Mlkurta/ENCE_3231_Embedded_Systems/PhaseB/STM32Demo/Readme.md

# STM32 Demo

This is a Project created by mirroring the KiCAD board design process by Philip Salmony of Phil's Lab.

The creation video can be found here: https://youtu.be/aVUqaB0IMh4?si=m5vGeWEMC6P6GTJ3

Schematic:



Board layout:

PCB_Layout

Board Model:
