Mlkurta/ENCE_3231_Embedded_Systems/Phase_A/Ultrasonic_Project/Readme.md

STM_Ultrasoun

(Range variable is at the bottom in cm)
