Mlkurta/ENCE_3231_Embedded_Systems/PhaseB/2_Wheel_Robot_Complete/Docs/Board_Back.png

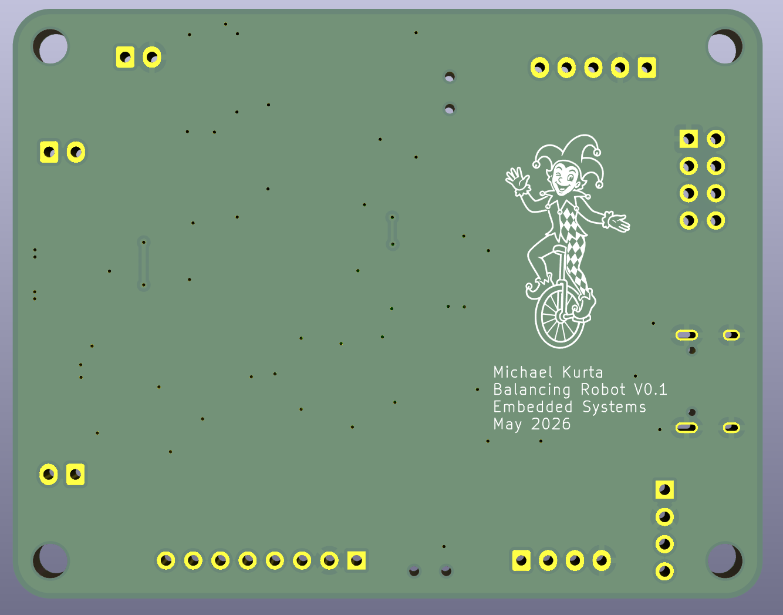
PhaseB/2_Wheel_Robot_Complete/Docs/Board_Back.png
