Mlkurta/ENCE_3231_Embedded_Systems/PhaseB/2_Wheel_Robot_Complete/Docs/Layout.png

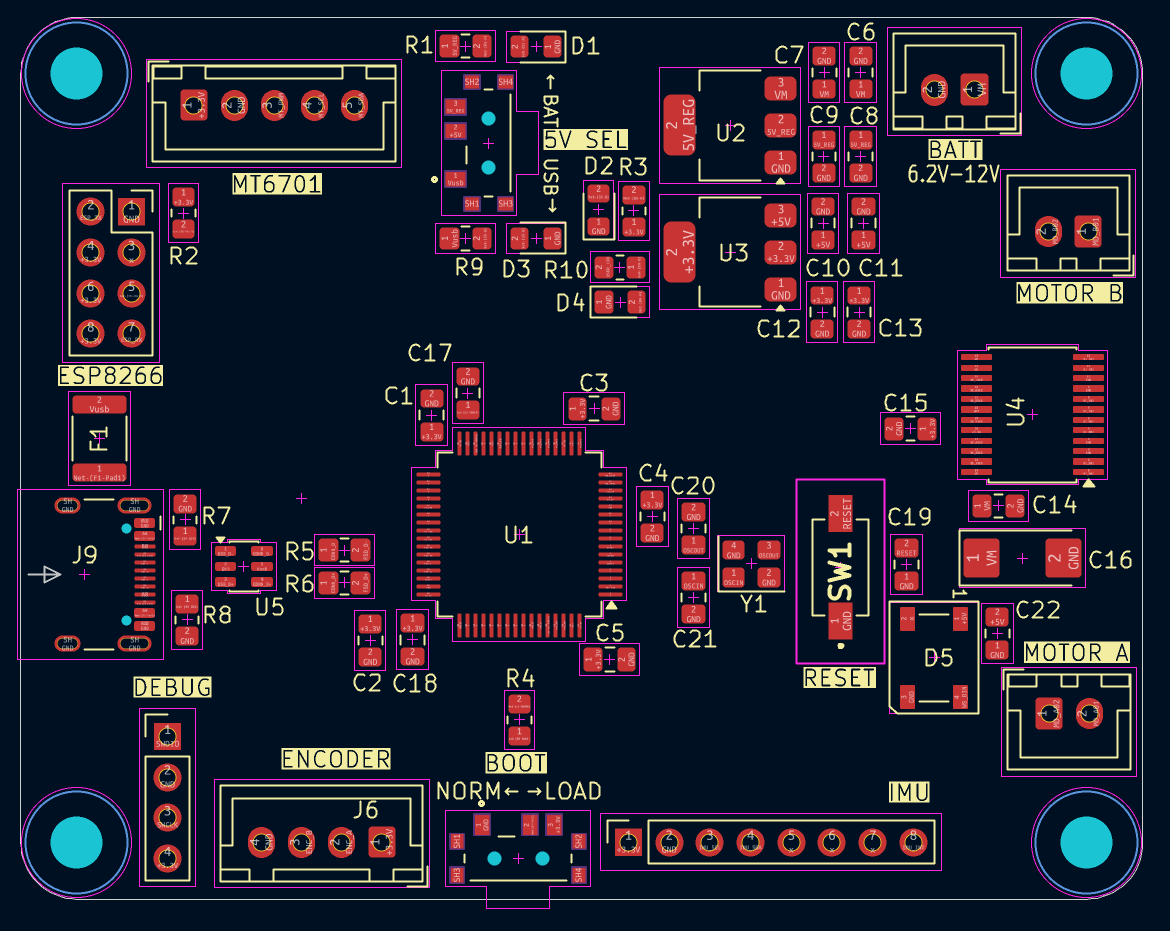
PhaseB/2_Wheel_Robot_Complete/Docs/Layout.png
