Mlkurta/ENCE_3231_Embedded_Systems/PhaseB/STM32Demo/Docs/Board_Front.png

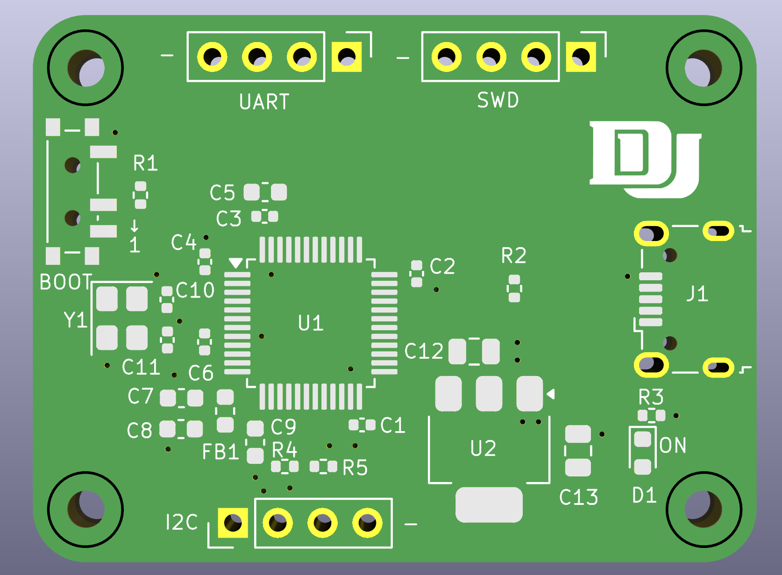
PhaseB/STM32Demo/Docs/Board_Front.png
