Mlkurta/ENCE_3231_Embedded_Systems/PhaseB/STM32Demo/Docs/PCB_Layout.png

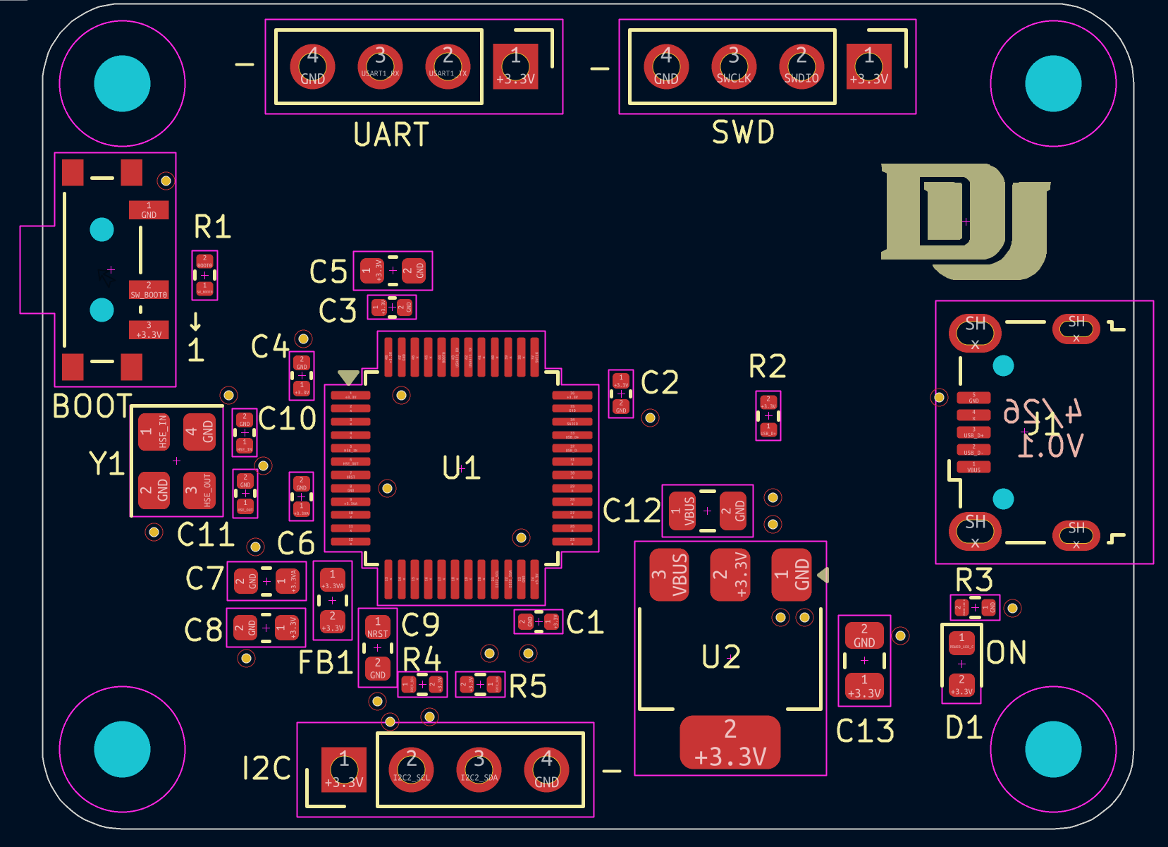
PhaseB/STM32Demo/Docs/PCB_Layout.png
