Mlkurta/ENCE_3231_Embedded_Systems/PhaseB/2_Wheel_Robot_Complete/Components/components/ESP8266-01_ESP-01/step/ESP8266-01_ESP-01.step

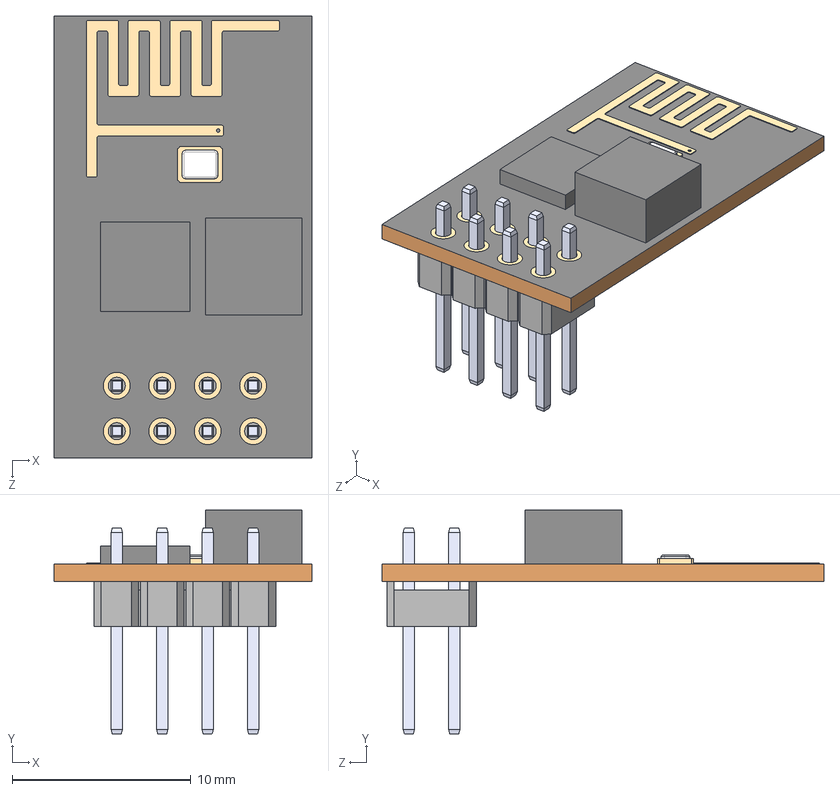
[picture p10: CAD file, 2026-04-23]
PhaseB/2_Wheel_Robot_Complete/Components/components/ESP8266-01_ESP-01/step/ESP8266-01_ESP-01.step
14.4 x 12.5 x 24.7 mm
