Mlkurta/ENCE_3231_Embedded_Systems/PhaseB/2_Wheel_Robot_Complete/Components/components/MPU6050/ITG-MPU.STEP

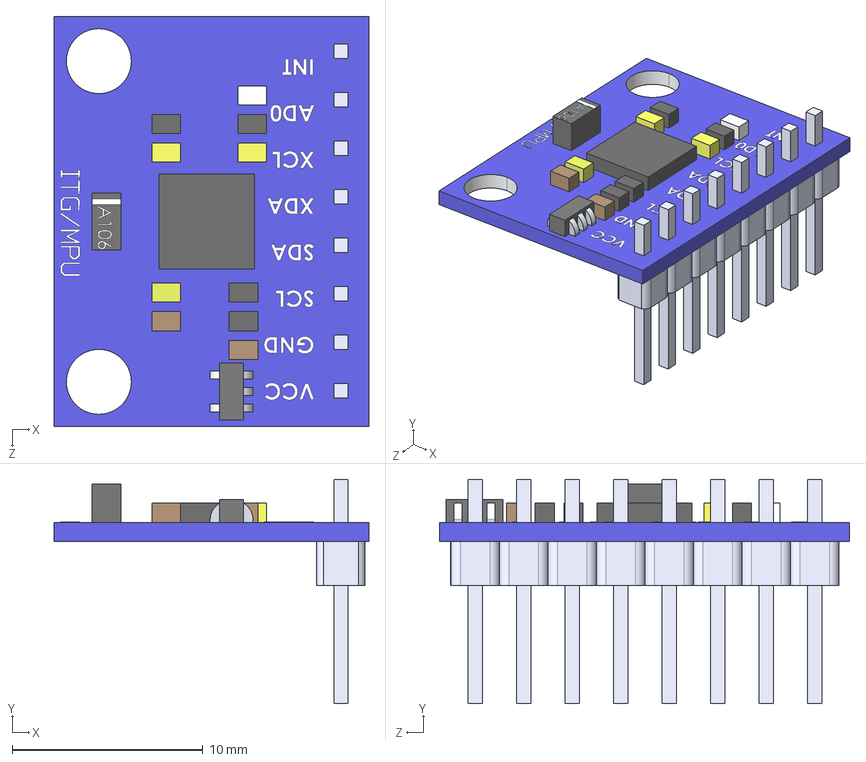
[picture p12: CAD file, 2026-04-23]
PhaseB/2_Wheel_Robot_Complete/Components/components/MPU6050/ITG-MPU.STEP
16.5 x 11.8 x 21.5 mm
8 Header-Pin
Placa_Base
