Mlkurta/ENCE_3231_Embedded_Systems/PhaseB/2_Wheel_Robot_Complete/Components/components/SPDT_Slide_Switch/step/SLW-66527511-SMT-TR.step

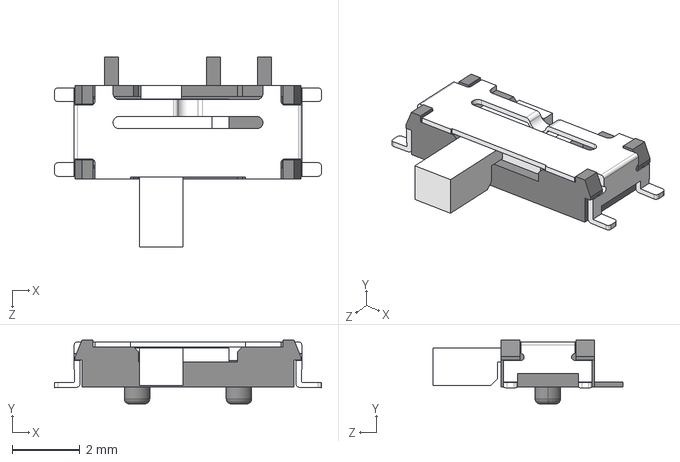
[picture p13: CAD file, 2026-04-23]
PhaseB/2_Wheel_Robot_Complete/Components/components/SPDT_Slide_Switch/step/SLW-66527511-SMT-TR.step
7.86 x 1.88 x 5.58 mm
