Mlkurta/ENCE_3231_Embedded_Systems/PhaseB/2_Wheel_Robot_Complete/Components/components/SW_uP_Reset/step/SW_uP_Reset.stp

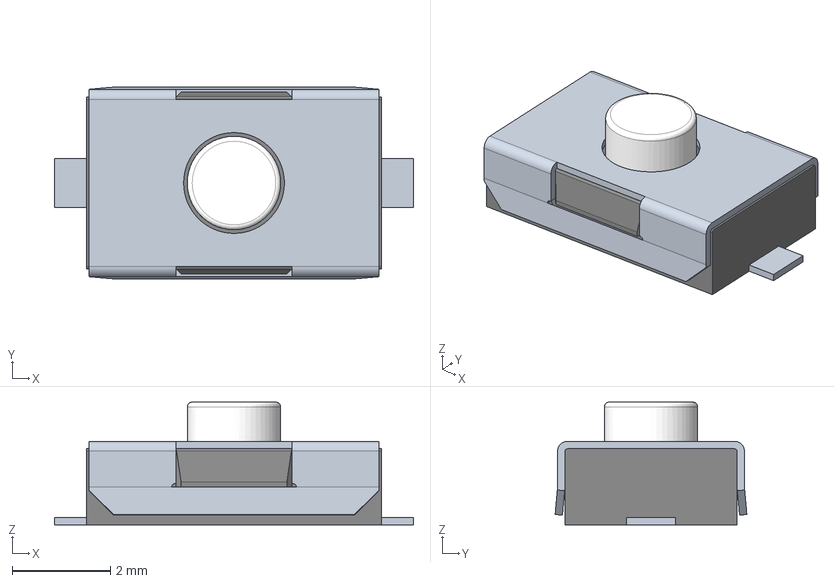
[picture p14: CAD file, 2026-04-23]
PhaseB/2_Wheel_Robot_Complete/Components/components/SW_uP_Reset/step/SW_uP_Reset.stp
7.30 x 3.90 x 2.50 mm
