Mlkurta/ENCE_3231_Embedded_Systems/PhaseB/STM32Demo/Docs/STM32Demo.step

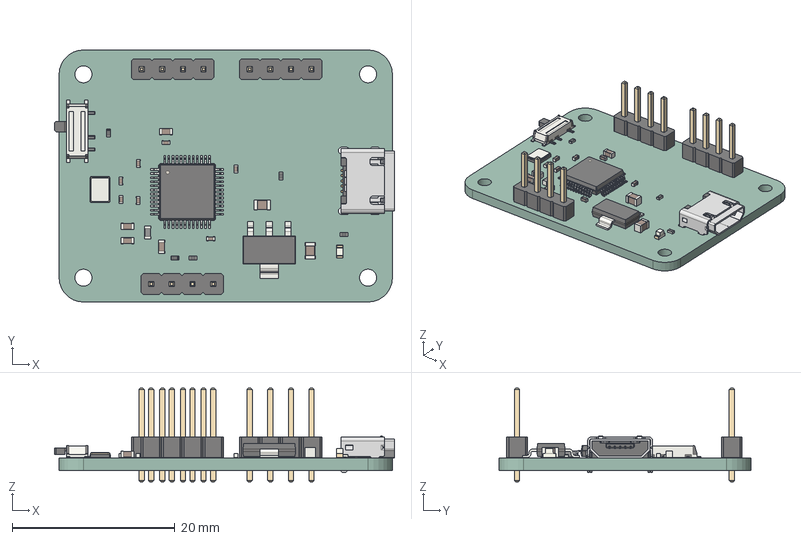
[picture p15: CAD file, 2026-04-25]
PhaseB/STM32Demo/Docs/STM32Demo.step
41.8 x 31.0 x 11.5 mm
R_0402_1005Metric x 5
C_0402_1005Metric x 7
PinHeader_1x04_P2.54mm_Vertical x 3
L_0603_1608Metric
C_0805_2012Metric x 2
C_0603_1608Metric x 4
Crystal_SMD_3225-4Pin_3.2x2.5mm
629105150521_Housing
629105150521_Pin1 x 4
629105150521_Pin2
629105150521_Shielding2
629105150521_Shielding
SOT-223
LQFP-48_7x7mm_P0.5mm
LED_0603_1608Metric
SW_SPDT_PCM12
STM32Demo_PCB
