Mlkurta/ENCE_3231_Embedded_Systems/PhaseB/STM32Demo/Components/components/Wurth_USB/629105150521 (rev1).stp

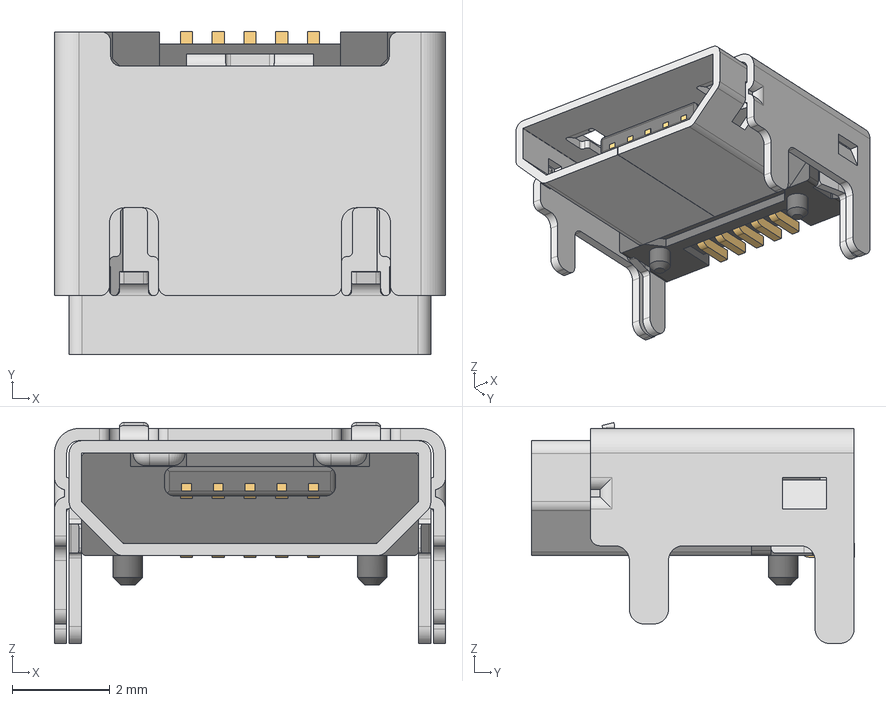
[picture p16: CAD file, 2026-04-25]
PhaseB/STM32Demo/Components/components/Wurth_USB/629105150521 (rev1).stp
8.00 x 6.60 x 4.52 mm
629105150521_Housing
629105150521_Pin1 x 4
629105150521_Pin2
629105150521_Shielding2
629105150521_Shielding
