Mlkurta/ENCE_3231_Embedded_Systems/PhaseB/STM32Demo/Docs/Schematic.pdf

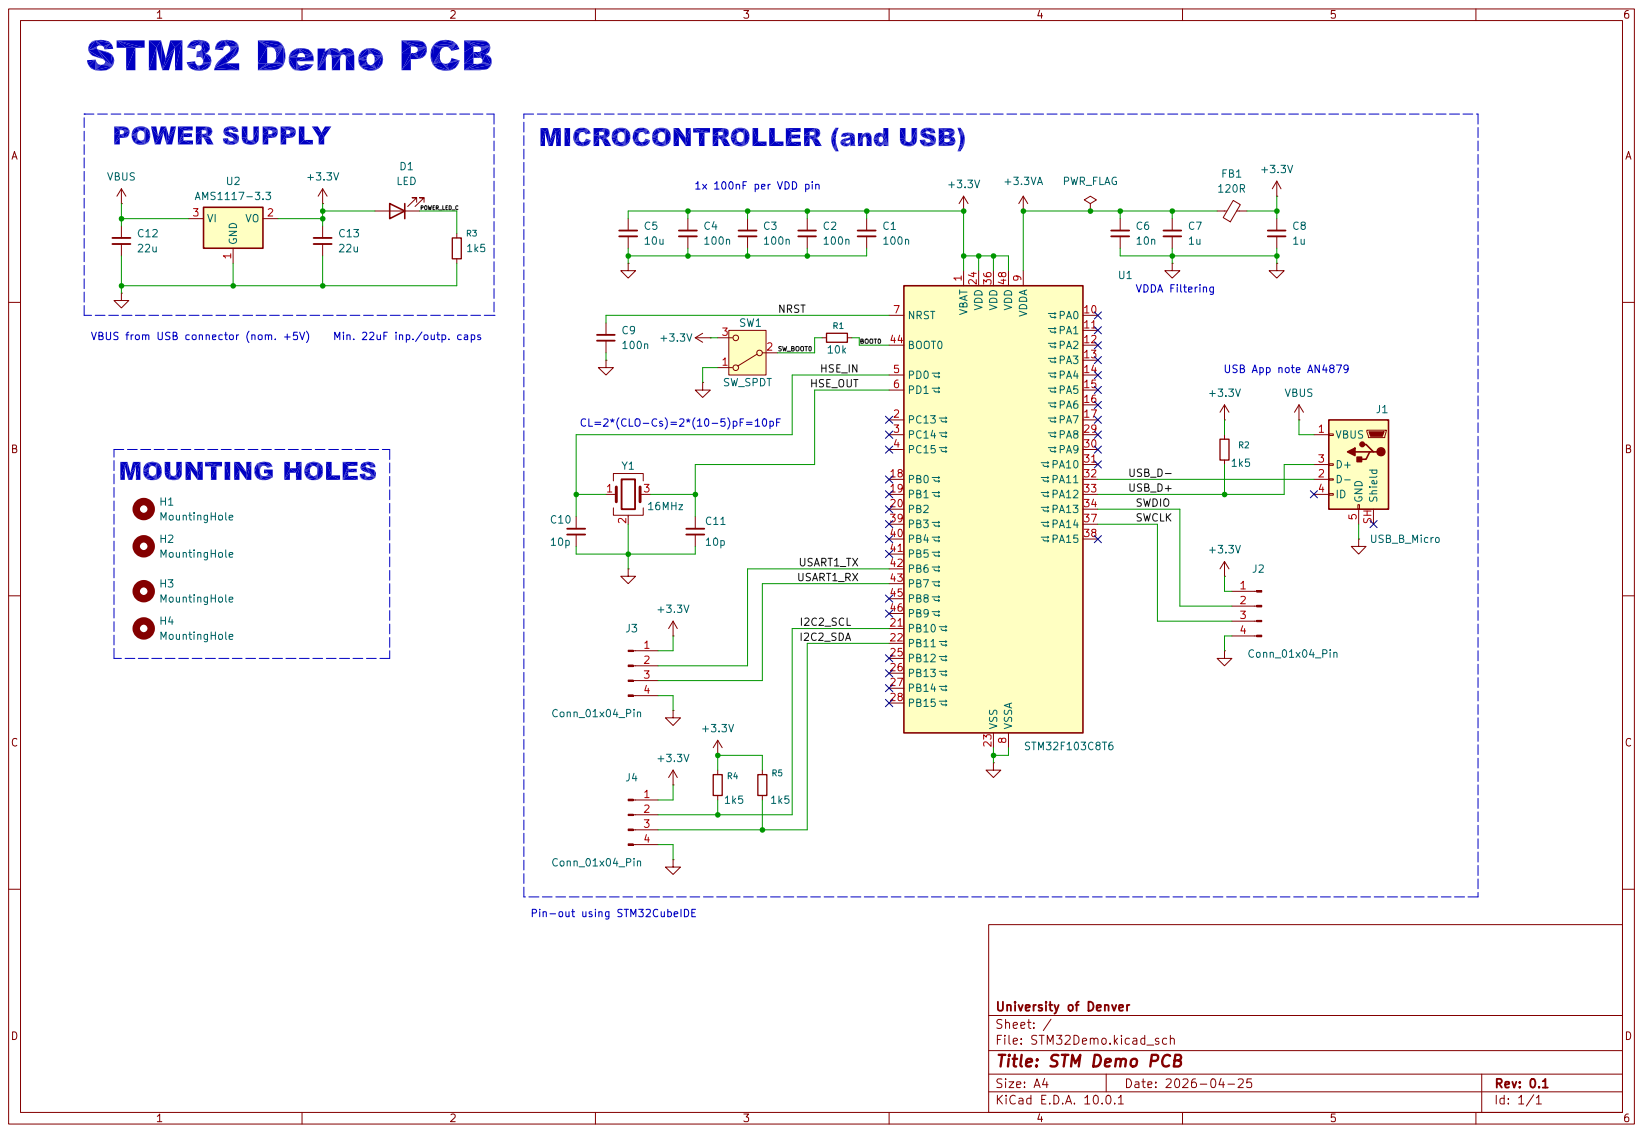
[picture p18: page 1]
