Mlkurta/ENCE_3231_Embedded_Systems/PhaseB/2Wheel_Robot/Docs/Schematic.pdf

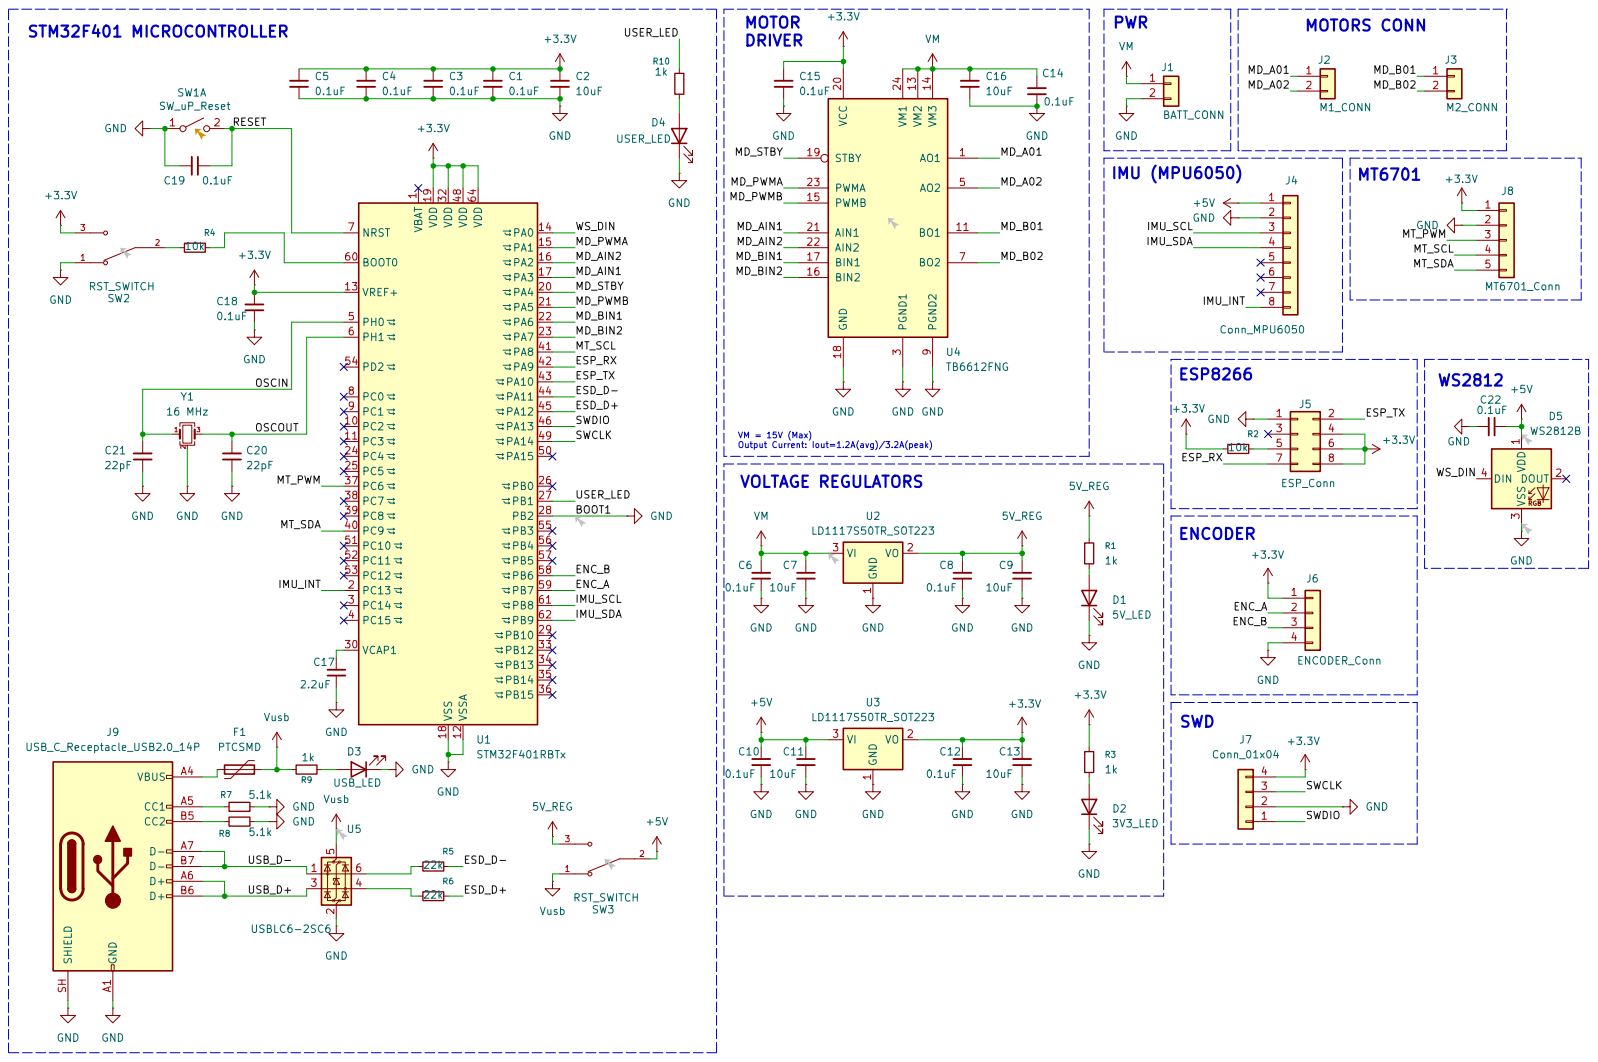
[picture p19: page 1]
