Mlkurta/ENCE_3231_Embedded_Systems/PhaseB/STM32Demo/STM32Demo.kicad_pcb

## KiCad design PhaseB/STM32Demo/STM32Demo.kicad_pcb (2026-04-25)

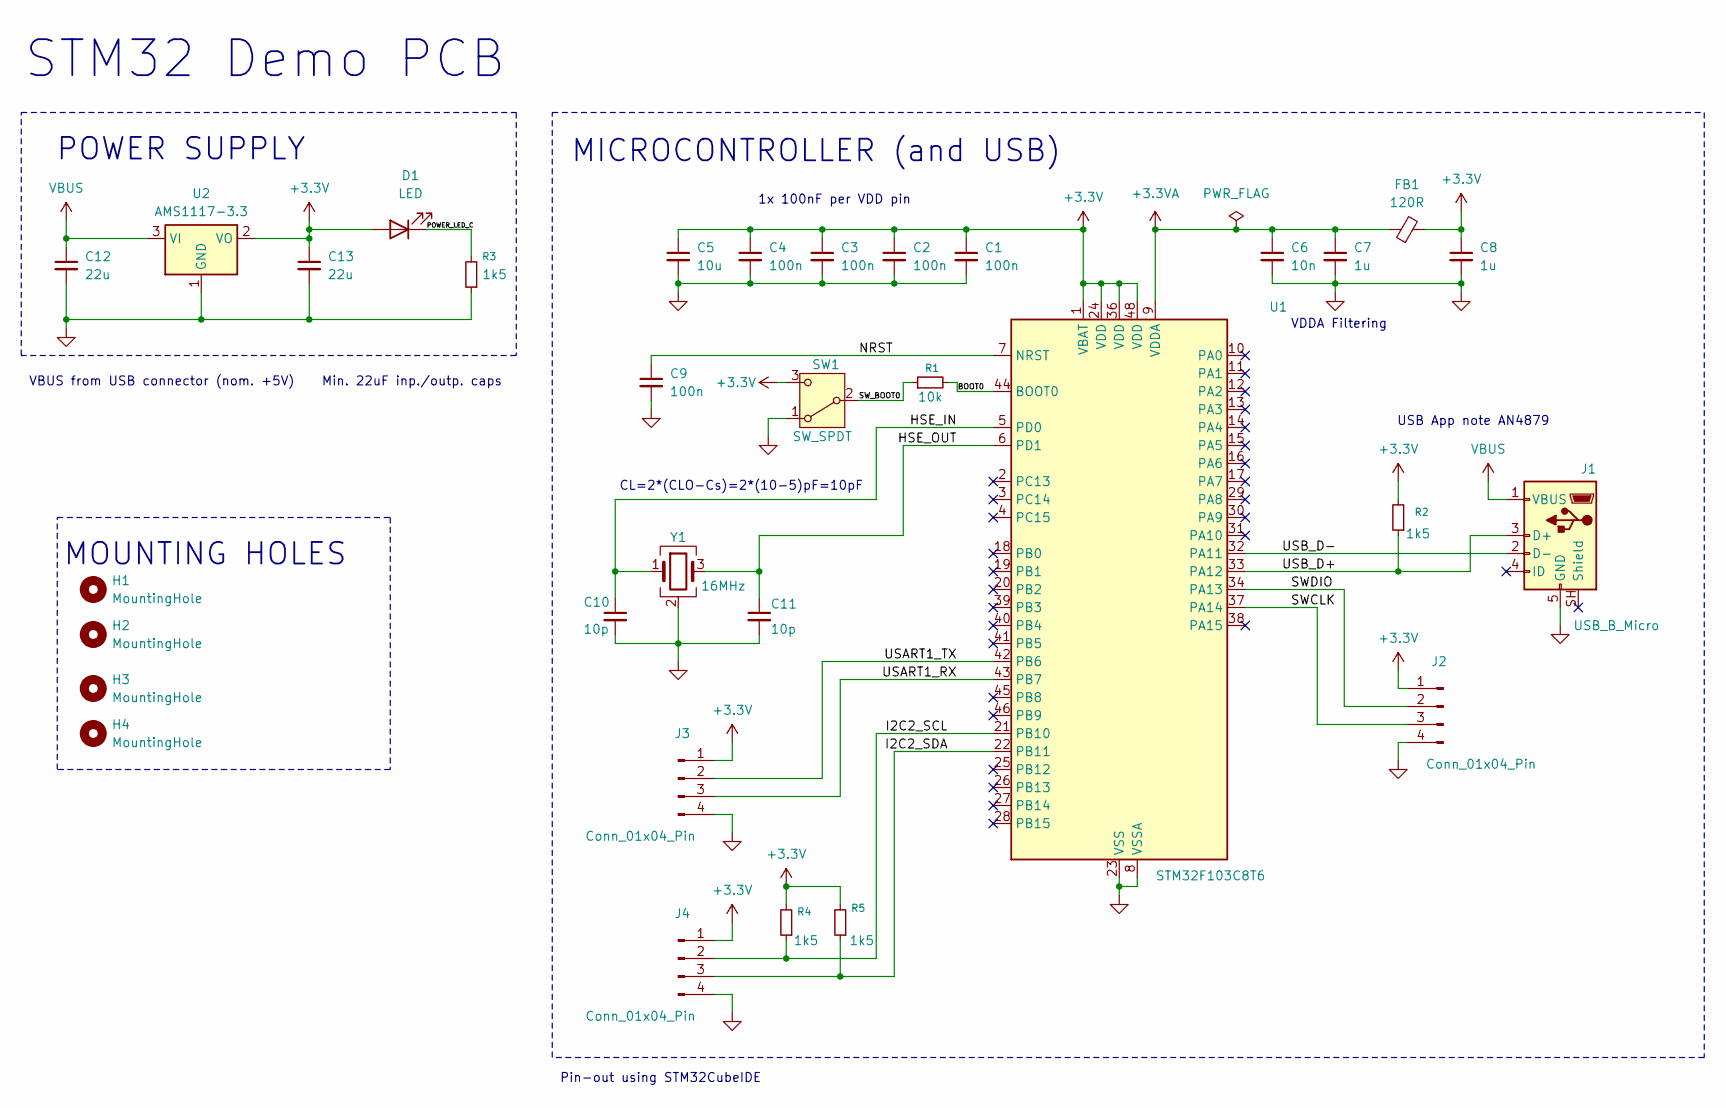
[picture p22: schematic STM32Demo.kicad_sch, STM Demo PCB]

Parts:
C1, C2, C3, C4: 100n; C_0402_1005Metric
C5: 10u; C_0603_1608Metric
C6: 10n; C_0402_1005Metric
C7, C8: 1u; C_0603_1608Metric
C9: 100n; C_0603_1608Metric
C10, C11: 10p; C_0402_1005Metric
C12, C13: 22u; C_0805_2012Metric
D1: LED; LED_0603_1608Metric
FB1: 120R; L_0603_1608Metric
H1, H2, H3, H4: MountingHole; MountingHole_2.1mm
J1: USB_B_Micro; USB_Micro-B_Wuerth_629105150521
J2, J3, J4: Conn_01x04_Pin; PinHeader_1x04_P2.54mm_Vertical
R1: 10k; R_0402_1005Metric
R2, R3, R4, R5: 1k5; R_0402_1005Metric
SW1: SW_SPDT; SW_SPDT_PCM12
U1: STM32F103C8T6; LQFP-48_7x7mm_P0.5mm
U2: AMS1117-3.3; SOT-223-3_TabPin2
Y1: 16MHz; Crystal_SMD_3225-4Pin_3.2x2.5mm

Connections:
+3.3V: C1.1, C2.1, C3.1, C4.1, C5.1, C8.1, C13.1, D1.2 (A), FB1.2, J2.1, J3.1, J4.1, R2.2, R4.2, R5.2, SW1.3 (C), U1.1 (VBAT), U1.24 (VDD), U1.36 (VDD), U1.48 (VDD), U2.2 (VO)
+3.3VA: C6.1, C7.1, FB1.1, U1.9 (VDDA)
/BOOT0: R1.2, U1.44 (BOOT0)
/HSE_IN: C10.1, U1.5 (PD0), Y1.1
/HSE_OUT: C11.1, U1.6 (PD1), Y1.3
/I2C2_SCL: J4.2, R4.1, U1.21 (PB10)
/I2C2_SDA: J4.3, R5.1, U1.22 (PB11)
/NRST: C9.1, U1.7 (NRST)
/POWER_LED_C: D1.1 (K), R3.2
/SWCLK: J2.3, U1.37 (PA14)
/SWDIO: J2.2, U1.34 (PA13)
/SW_BOOT0: R1.1, SW1.2 (B)
/USART1_RX: J3.3, U1.43 (PB7)
/USART1_TX: J3.2, U1.42 (PB6)
/USB_D+: J1.3 (D+), R2.1, U1.33 (PA12)
/USB_D-: J1.2 (D-), U1.32 (PA11)
GND: C1.2, C2.2, C3.2, C4.2, C5.2, C6.2, C7.2, C8.2, C9.2, C10.2, C11.2, C12.2, C13.2, J1.5 (GND), J2.4, J3.4, J4.4, R3.1, SW1.1 (A), U1.8 (VSSA), U1.23 (VSS), U1.35 (VSS), U1.47 (VSS), U2.1 (GND), Y1.2 (G), Y1.4 (G)
VBUS: C12.1, J1.1 (VBUS), U2.3 (VI)

Notes on the sheet:
Pin-out using STM32CubeIDE
1x 100nF per VDD pin
STM32 Demo PCB
CL=2*(CLO-Cs)=2*(10-5)pF=10pF
VBUS from USB connector (nom. +5V) Min. 22uF inp./outp. caps
VDDA Filtering
MOUNTING HOLES
POWER SUPPLY
MICROCONTROLLER (and USB)
USB App note AN4879

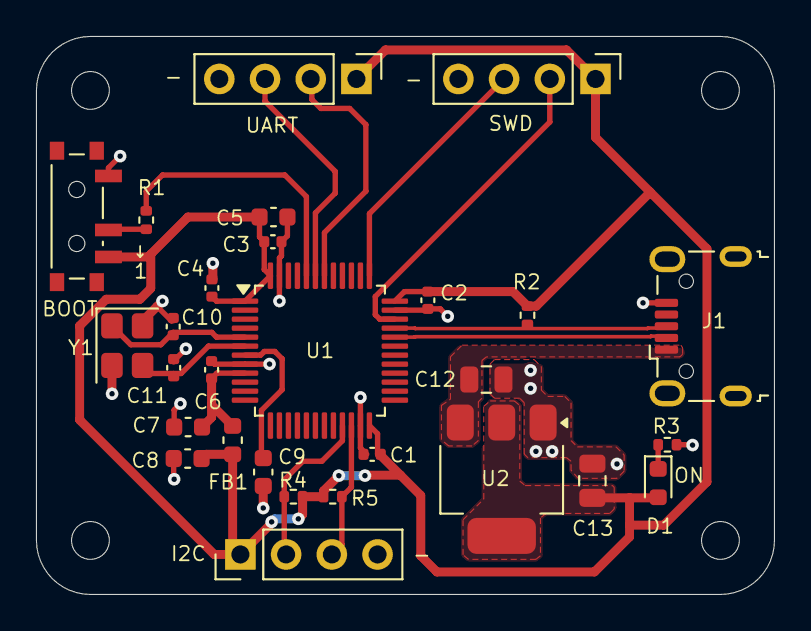
[picture p23: board STM32Demo.kicad_pcb from above]

Board: 2 copper layers, 41.0 x 31.0 mm, 32 parts (0 on the bottom side), 18 nets.
