Mlkurta/ENCE_3231_Embedded_Systems/Phase_D/2026_STM32F401_2Wheel_Balance/Core/Src/main.c

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
/* Includes ------------------------------------------------------------------*/
#include "main.h"

/* USER CODE BEGIN Includes */
#include <stdio.h>  // snprintf

#include "ENGREDU_WS2812.h"
#include "TJ_MPU6050.h"
#include "ENGREDU_TB6612.h"
#include "ENGREDU_MT6701.h"
/* USER CODE END Includes */

/* USER CODE BEGIN PD */
#define ANGLE_DEADBAND 2.0f			// Deadband to account for slightly off center balance
#define RATE_DEADBAND 5.0f			// Deadband to account for noisy rate
#define PITCH_RATE_BIAS -4.0f		// Calibrate for pitch rate when motionless
#define TARGET_ALPHA 0.08f
#define LEFT_MIN_PWM   16.0f
#define RIGHT_MIN_PWM  11.0f
#define PWM_DEADBAND 8.0f
#define SPEED_DEADBAND 20.0f
#define START_KICK_PWM 1.5f
#define MAX_SPEED 300.0f
/* USER CODE END PD */

I2C_HandleTypeDef hi2c1;
I2C_HandleTypeDef hi2c3;

TIM_HandleTypeDef htim2;
TIM_HandleTypeDef htim3;
TIM_HandleTypeDef htim4;
TIM_HandleTypeDef htim5;
DMA_HandleTypeDef hdma_tim5_ch1;

UART_HandleTypeDef huart1;

PCD_HandleTypeDef hpcd_USB_OTG_FS;

/* USER CODE BEGIN PV */

uint8_t gTMP = 0;

// Simple Scheduler
uint32_t last_led_tick        = 0; // Timestamp of the last LED toggle for blinking
uint32_t last_telemetry_tick  = 0; // Timestamp of the last telemetry transmission for periodic updates

// UART
uint8_t uart_rx_byte; // Buffer for receiving a single byte over UART
volatile uint8_t gUART_Cmd;

float applyMinPWM(float cmd, float minPwm);

char gTelemetry[64];

const float gKp = 5.25f;				// Proportional constant
const float gKd = 0.1f;			// Derivative constant
const float gKvBackward = 0.18f;			// Velocity constant (only with encoder)
const float gKvForward = 0.12f;			// Velocity constant (only with encoder)
const float RIGHT_PWM_MOD = 0.92f;	// Modifier to counteract a slower left motor
const float DIFFERENTIAL_TURN = 15.0;
float  		gTargetPitchCmd = 9.0f;    // Target pitch value to balance to
float 		gTurnCmd = 0.0f;		// Turn modifier to allow turning while balancing
float 		gDesiredSpeed = 0.0f;



// Uncomment if using encoder + interrupt flag
volatile uint8_t encoderUpdateFlag = 0;

// MPU6050 + complementary filter
CompFilter_Def gCompFilter;
uint32_t last_imu_tick = 0;

// TB6612

TB6612_Motor gMotorA = {
		.htim = &htim2, // timer for PWM
		.Channel = TIM_CHANNEL_2,
		.IN1_Port = AIN1_GPIO_Port,
		.IN1_Pin = AIN1_Pin,
		.IN2_Port = AIN2_GPIO_Port,
		.IN2_Pin = AIN2_Pin,
		.STBY_Port = STANDBY_GPIO_Port,
		.STBY_Pin = STANDBY_Pin,
		.Offset = 1
};

TB6612_Motor gMotorB = {
		.htim = &htim2, // timer for PWM
		.Channel = TIM_CHANNEL_1,
		.IN1_Port = BIN1_GPIO_Port,
		.IN1_Pin = BIN1_Pin,
		.IN2_Port = BIN2_GPIO_Port,
		.IN2_Pin = BIN2_Pin,
		.STBY_Port = STANDBY_GPIO_Port,
		.STBY_Pin = STANDBY_Pin,
		.Offset = 1
};

// MT6701
MT6701_Handle encoder;

/* USER CODE END PV */

void SystemClock_Config(void);
static void MX_GPIO_Init(void);
static void MX_DMA_Init(void);
static void MX_I2C1_Init(void);
static void MX_I2C3_Init(void);
static void MX_TIM4_Init(void);
static void MX_TIM5_Init(void);
static void MX_USART1_UART_Init(void);
static void MX_USB_OTG_FS_PCD_Init(void);
static void MX_TIM2_Init(void);
static void MX_TIM3_Init(void);
/**
  * @brief  The application entry point.
  * @retval int
  */
int main(void)
{

  /* USER CODE BEGIN 1 */
	MPU_ConfigTypeDef myMpuConfig;
  /* USER CODE END 1 */

  /* MCU Configuration--------------------------------------------------------*/

  /* Reset of all peripherals, Initializes the Flash interface and the Systick. */
  HAL_Init();

  /* Configure the system clock */
  SystemClock_Config();

  /* Initialize all configured peripherals */
  MX_GPIO_Init();
  MX_DMA_Init();
  MX_I2C1_Init();
  MX_I2C3_Init();
  MX_TIM4_Init();
  MX_TIM5_Init();
  MX_USART1_UART_Init();
  MX_USB_OTG_FS_PCD_Init();
  MX_TIM2_Init();
  MX_TIM3_Init();
  /* USER CODE BEGIN 2 */

  //1. Initialize the MPU6050 module and I2C1
  MPU6050_Init(&hi2c1);
  //2. Configure Accel and Gyro parameters
  myMpuConfig.Accel_Full_Scale = AFS_SEL_4g;
  myMpuConfig.ClockSource = Internal_8MHz;
  myMpuConfig.CONFIG_DLPF = DLPF_184A_188G_Hz;
  myMpuConfig.Gyro_Full_Scale = FS_SEL_500;
  myMpuConfig.Sleep_Mode_Bit = 0;  //1: sleep mode, 0: normal mode
  MPU6050_Config(&myMpuConfig);
  HAL_Delay(50); // gyro needs ~30 ms to stabilize after power-on
  MPU6050_CompFilter_Init(&gCompFilter, 0.995f);

  // Initialize WS2812 LED strip with TIM5 and set pixel color
  WS2812_Init(&htim5);
  WS2812_SetPixel(30, 30, 30);

  // Start UART reception in interrupt mode for 1 byte
  HAL_UART_Receive_IT(&huart1, &uart_rx_byte, 1);

  // Initialize Motors
  TB6612_Init(&gMotorA);  // the other motor (left)
  TB6612_Init(&gMotorB);  // motor with encoder (right)

  TB6612_Brake(&gMotorA);
  TB6612_Brake(&gMotorB);

  // Initialize Encoder
//  //1. Initialize MT6701 with I2C3
  MT6701_Init(&encoder, &hi2c3);
  MT6701_SetZero(&encoder);
//  //2. Initialize Timer 3 for Encoder
  HAL_TIM_Base_Start_IT(&htim3);
  float speed = 0.0f;
  float roll  = 0.0f;  /* side angle */
  float rate = 	0.0f;
  float cmd = 0.0f;
  float targetPitch = gTargetPitchCmd;
  int16_t pitch = 0;  /* front angle */
  int16_t counter = gTMP;  /* counter */

  /* USER CODE END 2 */

  /* Infinite loop */
  /* USER CODE BEGIN WHILE */
  while (1)
  {

	  // TODO
	  uint32_t now = HAL_GetTick(); // Get the current system tick in milliseconds

	  // Toggle the user LED every 100 ms for a blinking effect
	  if (now - last_led_tick >= 100)
	  {
		  last_led_tick = now;
		  HAL_GPIO_TogglePin(USER_LED_GPIO_Port, USER_LED_Pin);
	  }
	   //Encoder update
	  if (encoderUpdateFlag)
	  {
	      encoderUpdateFlag = 0;
	      MT6701_Update(&encoder, 0.1f);
	  }



	  // Read IMU and run complementary filter at 100 Hz (10 ms)
	  if (now - last_imu_tick >= 10)
	  {
	      float dt = (now - last_imu_tick) * 0.001f;
	      last_imu_tick = now;

	      MPU6050_CompFilter_Update(&gCompFilter, dt);

	      targetPitch += TARGET_ALPHA * (gTargetPitchCmd - targetPitch);

	      speed = -encoder.velocity_deg_s;   // negative = forward = shows positive

	      float pitch = gCompFilter.pitch;
	      float rawRate = gCompFilter.pitchAngleRate;
	      float rate = rawRate - PITCH_RATE_BIAS;

	      float error = pitch - targetPitch;
	      float speedError = speed - gDesiredSpeed;
	      bool noDriveCommand = fabsf(gDesiredSpeed) < 1.0f;
	      bool noTurnCommand  = fabsf(gTurnCmd) < 1.0f;

	      float cmd = 0.0f;

	      if (noDriveCommand &&
	          noTurnCommand &&
	          fabsf(error) < ANGLE_DEADBAND &&
	          fabsf(rate) < RATE_DEADBAND)
	      {
			  cmd = 0.0f;
		  }
	      else
	      {
	          if (fabsf(rate) < RATE_DEADBAND)
	          {
	              rate = 0.0f;
	          }

	          float turnScale =
	              1.0f - fminf(fabsf(gTurnCmd) / 20.0f, 1.0f);
	          float driveFF = 0.0f;
	          float pTerm = gKp * error;
	          float dTerm = gKd * rate;

	          float Kv = (speed > 0.0f) ? gKvForward : gKvBackward;
	          if (fabsf(speed) > fabsf(gDesiredSpeed) && !noDriveCommand) {
	              Kv *= 1.3;   // larger
	          }
	          float vTerm = Kv * speedError * turnScale;

	          cmd = pTerm + dTerm + vTerm;

	          if (fabsf(gDesiredSpeed) > 1.0f && fabsf(speed) < 15.0f) {
	              cmd += (gDesiredSpeed > 0.0f) ? START_KICK_PWM : -START_KICK_PWM;

	          }

	          if (cmd > 50.0f)  cmd = 50.0f;
	          if (cmd < -50.0f) cmd = -50.0f;
	      }



	      float leftCmd  = cmd + gTurnCmd;
	      float rightCmd = cmd - gTurnCmd;

	      rightCmd *= RIGHT_PWM_MOD;

	      if (fabsf(leftCmd) > PWM_DEADBAND)
	          leftCmd = applyMinPWM(leftCmd, LEFT_MIN_PWM);
	      else
	          leftCmd = 0.0f;

	      if (fabsf(rightCmd) > PWM_DEADBAND)
	          rightCmd = applyMinPWM(rightCmd, RIGHT_MIN_PWM);
	      else
	          rightCmd = 0.0f;

	      TB6612_Drive(&gMotorA, rightCmd);
	      TB6612_Drive(&gMotorB, leftCmd);
	  }

	  // Send telemetry data every 100 ms
	  if (now - last_telemetry_tick >= 100)
	  {
		  last_telemetry_tick = now;

	      //speed = encoder.velocity_deg_s;  /* encoder-derived wheel speed */
	      roll  = gCompFilter.roll;  /* side angle */
	      rate 	= 	gCompFilter.pitchAngleRate - PITCH_RATE_BIAS;
	      pitch = gCompFilter.pitch;  /* front angle */
	      counter = gTMP;  /* counter */

	      int len = snprintf(gTelemetry, sizeof(gTelemetry),
	                         "$%.2f,%.2f,%d,%d\r\n",
							 speed, rate, pitch, counter);
	      HAL_UART_Transmit_IT(&huart1, (uint8_t *)gTelemetry, len);

	      gTMP = (gTMP + 1) % 20;
	  }

      if (gUART_Cmd != 0)
      {
          switch (gUART_Cmd)
          {
              case 'w':
            	  WS2812_SetPixel(30, 0, 0);
            	  gTurnCmd = 0.0;
            	  gDesiredSpeed = MAX_SPEED;
            	  break;

              case 's':
            	  WS2812_SetPixel(0, 30, 0);
            	  gTurnCmd = 0.0;
            	  gDesiredSpeed = -MAX_SPEED;
            	  break;

              case 'a':
            	  WS2812_SetPixel(0, 0, 30);
//            	  TB6612_Drive(&gMotorA, 30 * LEFT_PWM_MOD);
//            	  TB6612_Brake(&gMotorB);
            	  gTurnCmd = -DIFFERENTIAL_TURN;
            	  break;

              case 'd':
            	  WS2812_SetPixel(30, 30, 0);
//            	  TB6612_Brake(&gMotorA);
//            	  TB6612_Drive(&gMotorB, 30);
            	  gTurnCmd = DIFFERENTIAL_TURN;
            	  break;

              case 'x':
            	  WS2812_SetPixel(0, 0, 0);
            	  gDesiredSpeed = 0.0f;
            	  gTurnCmd = 0.0;
            	  break;
          }
          gUART_Cmd = 0;
      }

    /* USER CODE END WHILE */

    /* USER CODE BEGIN 3 */
  }
  /* USER CODE END 3 */
}

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
/* USER CODE BEGIN 4 */


// TODO

float applyMinPWM(float cmd, float minPwm)
{
    if (cmd > 0.0f && cmd < minPwm)  return minPwm;
    if (cmd < 0.0f && cmd > -minPwm) return -minPwm;
    return cmd;
}

void HAL_TIM_PWM_PulseFinishedCallback(TIM_HandleTypeDef *htim)
{
    HAL_TIM_PWM_Stop_DMA(htim, TIM_CHANNEL_1);  // WS2812 DMA -> Timer5
}

// UART receive complete callback function to control the robot based on received byte
void HAL_UART_RxCpltCallback(UART_HandleTypeDef *huart)
{
    if (huart->Instance == USART1)
    {
    	gUART_Cmd = uart_rx_byte;
        HAL_UART_Receive_IT(&huart1, &uart_rx_byte, 1);
    }
}

// Re-arm RX IT after any UART error (e.g. overrun) so reception never dies
void HAL_UART_ErrorCallback(UART_HandleTypeDef *huart)
{
    if (huart->Instance == USART1)
    {
        HAL_UART_Receive_IT(&huart1, &uart_rx_byte, 1);
    }
}

void HAL_TIM_PeriodElapsedCallback(TIM_HandleTypeDef *htim){
	if(htim->Instance == TIM3){
		// Update Encoder flag
		encoderUpdateFlag = 1;
	}
}

/* USER CODE END 4 */
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
