Mlkurta/ENCE_3231_Embedded_Systems/Phase_D/2026_STM32F401_2Wheel_Balance/2026_STM32F401_3Wheel_Balance.ioc

Mcu.UserName=STM32F401RBTx
PA0-WKUP.Signal=S_TIM5_CH1
PA1.Signal=S_TIM2_CH2
PA10.Signal=USART1_RX
PA11.Signal=USB_OTG_FS_DM
PA12.Signal=USB_OTG_FS_DP
PA13.Signal=SYS_JTMS-SWDIO
PA14.Signal=SYS_JTCK-SWCLK
PA2.GPIO_Label=AIN2
PA2.Signal=GPIO_Output
PA3.GPIO_Label=AIN1
PA3.Signal=GPIO_Output
PA4.GPIO_Label=STANDBY
PA4.Signal=GPIO_Output
PA5.Signal=S_TIM2_CH1_ETR
PA6.GPIO_Label=BIN1
PA6.Signal=GPIO_Output
PA7.GPIO_Label=BIN2
PA7.Signal=GPIO_Output
PA8.Signal=I2C3_SCL
PA9.Signal=USART1_TX
PB1.GPIO_Label=USER_LED
PB1.Signal=GPIO_Output
PB6.Signal=S_TIM4_CH1
PB7.Signal=S_TIM4_CH2
PB8.Signal=I2C1_SCL
PB9.Signal=I2C1_SDA
PC13-ANTI_TAMP.GPIO_Label=IMU_INT
PC13-ANTI_TAMP.Signal=GPIO_Input
PC6.Signal=S_TIM3_CH1
PC9.Signal=I2C3_SDA
