Mlkurta/ENCE_3231_Embedded_Systems/(commit log)

2026-06-10 Add files via upload
    Adding files that previously didn't upload
    [TJ_MPU6050.h]
2026-06-10 Add files via upload
    Added files which originally failed in upload
    [ENGREDU_MT6701.c, TJ_MPU6050.c, main.c]
2026-06-10 Add files via upload
    Zip file with entire contents of the project folder for 2 wheel balancing
