Mlkurta/ENCE_3231_Embedded_Systems/(notices)

Notices in the files:
Phase_D/2026_STM32F401_2Wheel_Balance/Core/Src/main.c:
Copyright (c) 2026 STMicroelectronics.
All rights reserved.
This software is licensed under terms that can be found in the LICENSE file
